Cannon7206/NASA-Motherboard-V4/NASA Motherboard V4.kicad_pcb

## KiCad design NASA Motherboard V4.kicad_pcb (2026-02-16)

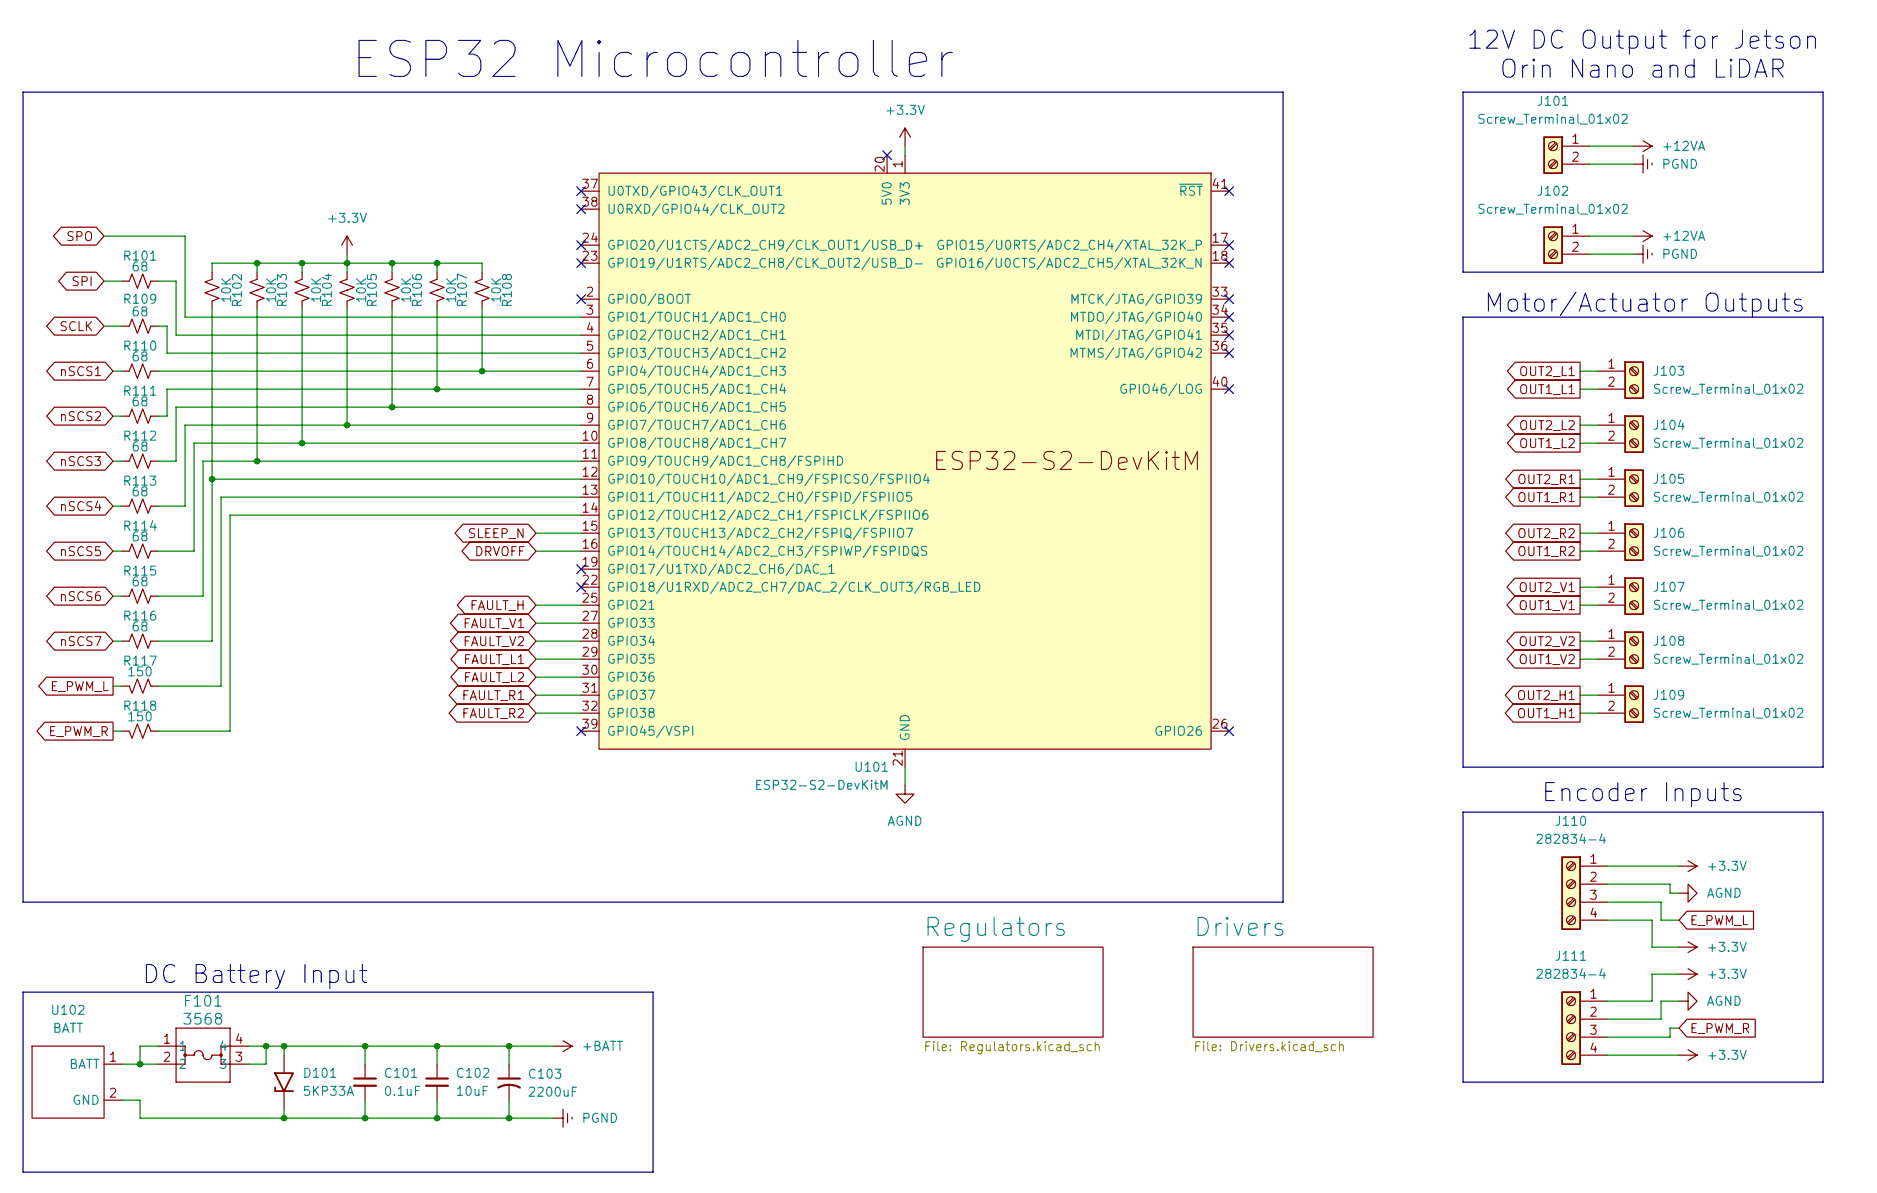
[picture p1: schematic NASA Motherboard V4.kicad_sch, NASA Lunabotics]

Parts:
C101: 0.1uF; C_0402_1005Metric_Pad0.74x0.62mm_HandSolder
C102: 10uF; C_1206_3216Metric_Pad1.33x1.80mm_HandSolder
C103: 2200uF; CP_Radial_D16.0mm_P7.50mm
D101: 5KP33A; D_P600_R-6_P20.00mm_Horizontal
F101: 3568; 3568_KEY
J101, J102: Screw_Terminal_01x02; TerminalBlock_TE_282834-2_1x02_P2.54mm_Horizontal; MFR Part # 282834-2
J103, J104, J105, J106, J107, J108, J109: Screw_Terminal_01x02; TerminalBlock_TE_282834-2_1x02_P2.54mm_Horizontal
J110, J111: 282834-4; TerminalBlock_TE_282834-4_1x04_P2.54mm_Horizontal; MFR Part # 282834-4
R101, R109, R110, R111, R112, R113, R114, R115, R116: 68; R_0402_1005Metric_Pad0.72x0.64mm_HandSolder
R102, R103, R104, R105, R106, R107, R108: 10K; R_0603_1608Metric_Pad0.98x0.95mm_HandSolder
R117, R118: 150; R_0603_1608Metric_Pad0.98x0.95mm_HandSolder
U101: ESP32-S2-DevKitM
U102: BATT; Battery Input

Connections:
+3.3V: J110.1, J110.4, J111.1, J111.4, R102.2, R103.2, R104.2, R105.2, R106.2, R107.2, R108.2, U101.1 (3V3); also elsewhere on the board
+12VA: J101.1, J102.1; also elsewhere on the board
+BATT: C101.1, C102.1, C103.1, D101.2 (A2), F101.3, F101.4; also elsewhere on the board
AGND: J110.2, J111.2, U101.21 (GND), U101.42 (GND); also elsewhere on the board
DRVOFF: U101.16 (GPIO14/TOUCH14/ADC2_CH3/FSPIWP/FSPIDQS); also elsewhere on the board
E_PWM_L: J110.3, R117.2
E_PWM_R: J111.3, R118.2
FAULT_H: U101.25 (GPIO21); also elsewhere on the board
FAULT_L1: U101.29 (GPIO35); also elsewhere on the board
FAULT_L2: U101.30 (GPIO36); also elsewhere on the board
FAULT_R1: U101.31 (GPIO37); also elsewhere on the board
FAULT_R2: U101.32 (GPIO38); also elsewhere on the board
FAULT_V1: U101.27 (GPIO33); also elsewhere on the board
FAULT_V2: U101.28 (GPIO34); also elsewhere on the board
unnamed: R101.2, U101.4 (GPIO2/TOUCH2/ADC1_CH1)
unnamed: R109.2, U101.5 (GPIO3/TOUCH3/ADC1_CH2)
unnamed: R108.1, R110.2, U101.6 (GPIO4/TOUCH4/ADC1_CH3)
unnamed: R107.1, R111.2, U101.7 (GPIO5/TOUCH5/ADC1_CH4)
unnamed: R106.1, R112.2, U101.8 (GPIO6/TOUCH6/ADC1_CH5)
unnamed: R105.1, R113.2, U101.9 (GPIO7/TOUCH7/ADC1_CH6)
unnamed: R104.1, R114.2, U101.10 (GPIO8/TOUCH8/ADC1_CH7)
unnamed: R103.1, R115.2, U101.11 (GPIO9/TOUCH9/ADC1_CH8/FSPIHD)
unnamed: R102.1, R116.2, U101.12 (GPIO10/TOUCH10/ADC1_CH9/FSPICS0/FSPIIO4)
unnamed: R117.1, U101.13 (GPIO11/TOUCH11/ADC2_CH0/FSPID/FSPIIO5)
unnamed: R118.1, U101.14 (GPIO12/TOUCH12/ADC2_CH1/FSPICLK/FSPIIO6)
unnamed: F101.1, F101.2, U102.1 (BATT)
OUT1_H1: J109.2; also elsewhere on the board
OUT1_L1: J103.2; also elsewhere on the board
OUT1_L2: J104.2; also elsewhere on the board
OUT1_R1: J105.2; also elsewhere on the board
OUT1_R2: J106.2; also elsewhere on the board
OUT1_V1: J107.2; also elsewhere on the board
OUT1_V2: J108.2; also elsewhere on the board
OUT2_H1: J109.1; also elsewhere on the board
OUT2_L1: J103.1; also elsewhere on the board
OUT2_L2: J104.1; also elsewhere on the board
OUT2_R1: J105.1; also elsewhere on the board
OUT2_R2: J106.1; also elsewhere on the board
OUT2_V1: J107.1; also elsewhere on the board
OUT2_V2: J108.1; also elsewhere on the board
PGND: C101.2, C102.2, C103.2, D101.1 (A1), J101.2, J102.2, U102.2 (GND); also elsewhere on the board
SCLK: R109.1; also elsewhere on the board
SLEEP_N: U101.15 (GPIO13/TOUCH13/ADC2_CH2/FSPIQ/FSPIIO7); also elsewhere on the board
SPI: R101.1; also elsewhere on the board
SPO: U101.3 (GPIO1/TOUCH1/ADC1_CH0); also elsewhere on the board
nSCS1: R110.1; also elsewhere on the board
nSCS2: R111.1; also elsewhere on the board
nSCS3: R112.1; also elsewhere on the board
nSCS4: R113.1; also elsewhere on the board
nSCS5: R114.1; also elsewhere on the board
nSCS6: R115.1; also elsewhere on the board
nSCS7: R116.1; also elsewhere on the board

Notes on the sheet:
Encoder Inputs
DC Battery Input
12V DC Output for Jetson Orin Nano and LiDAR
Motor/Actuator Outputs
ESP32 Microcontroller

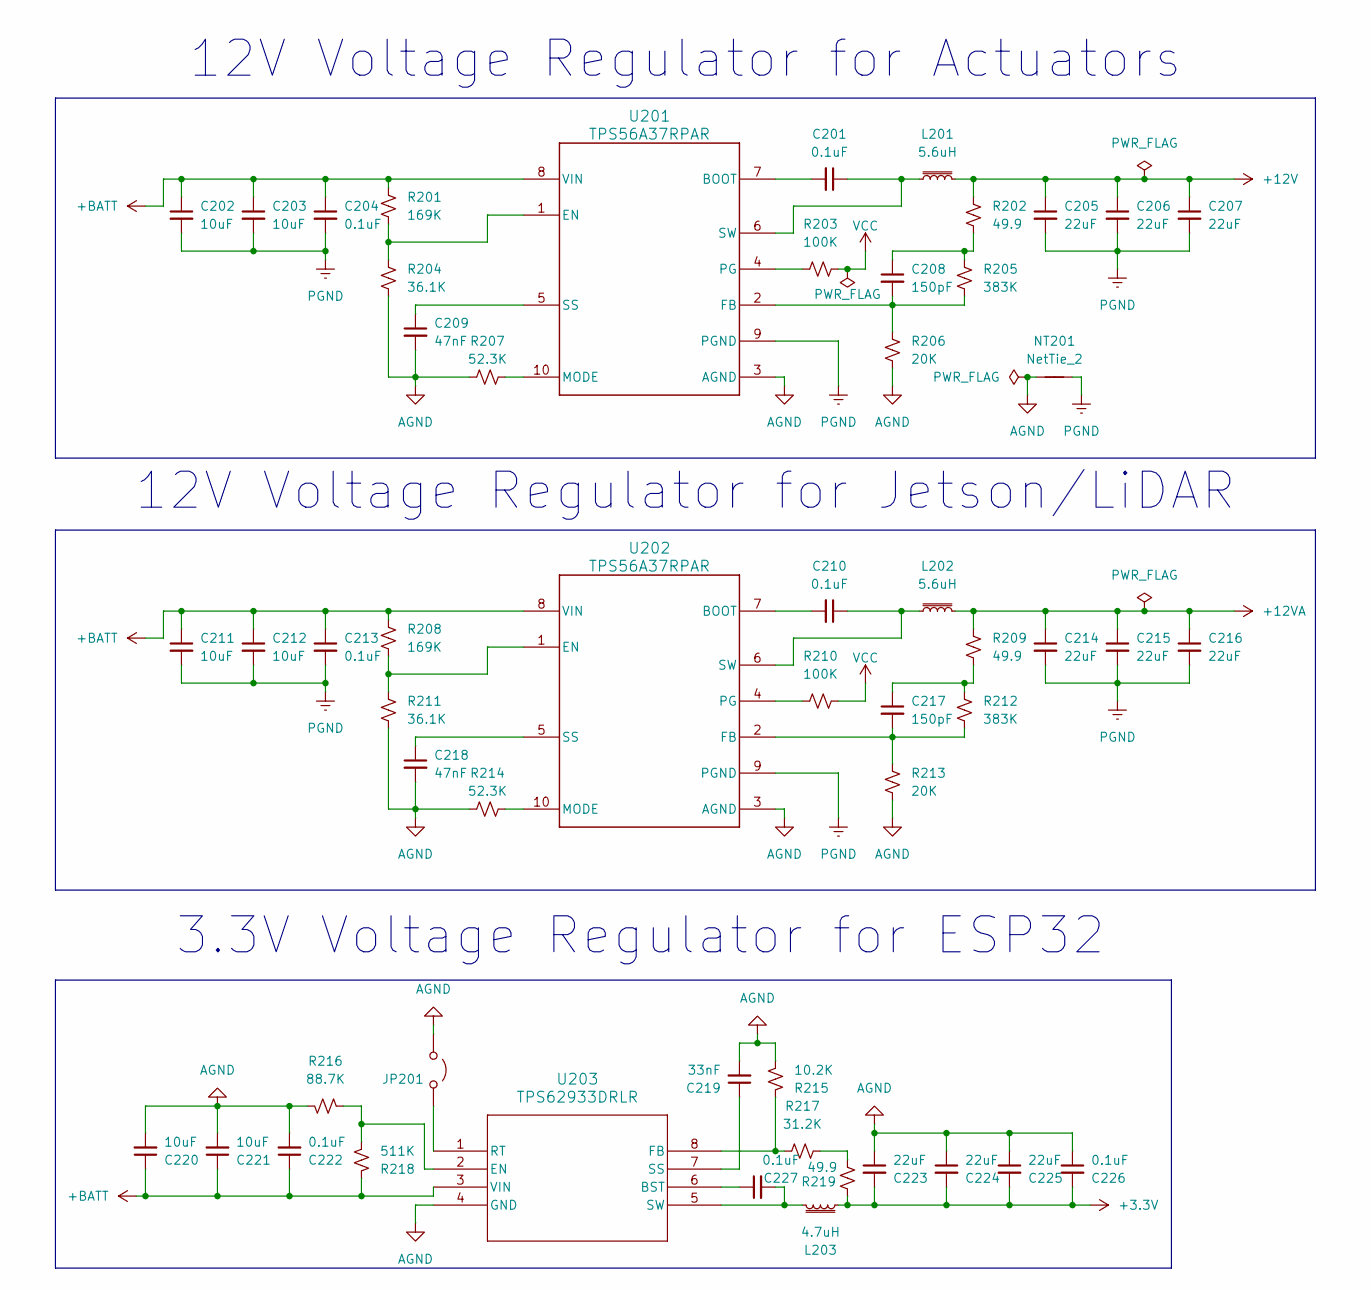
[picture p2: schematic Regulators.kicad_sch, NASA Lunabotics]

Parts:
C201, C204, C210, C213, C222, C226, C227: 0.1uF; C_0402_1005Metric_Pad0.74x0.62mm_HandSolder
C202, C203, C211, C212, C220, C221: 10uF; C_1206_3216Metric_Pad1.33x1.80mm_HandSolder
C205, C206, C207, C214, C215, C216, C223, C224, C225: 22uF; C_1210_3225Metric_Pad1.33x2.70mm_HandSolder
C208, C217: 150pF; C_0402_1005Metric_Pad0.74x0.62mm_HandSolder
C209, C218: 47nF; C_0603_1608Metric_Pad1.08x0.95mm_HandSolder
C219: 33nF; C_0603_1608Metric_Pad1.08x0.95mm_HandSolder
JP201: Jumper_2_Open; SolderJumper-2_P1.3mm_Open_Pad1.0x1.5mm
L201, L202: 5.6uH; IND_IHLP-6767DZ_VIS-M
L203: 4.7uH; IND_SRP6530A_BRN-M
NT201: NetTie_2; NetTie-2_THT_Pad1.0mm
R201, R208: 169K; R_0603_1608Metric_Pad0.98x0.95mm_HandSolder
R202, R209, R219: 49.9; R_0402_1005Metric_Pad0.72x0.64mm_HandSolder
R203, R210: 100K; R_0603_1608Metric_Pad0.98x0.95mm_HandSolder
R204, R211: 36.1K; R_0603_1608Metric_Pad0.98x0.95mm_HandSolder
R205, R212: 383K; R_0603_1608Metric_Pad0.98x0.95mm_HandSolder
R206, R213: 20K; R_0603_1608Metric_Pad0.98x0.95mm_HandSolder
R207, R214: 52.3K; R_0603_1608Metric_Pad0.98x0.95mm_HandSolder
R215: 10.2K; R_0603_1608Metric_Pad0.98x0.95mm_HandSolder
R216: 88.7K; R_0603_1608Metric_Pad0.98x0.95mm_HandSolder
R217: 31.2K; R_0603_1608Metric_Pad0.98x0.95mm_HandSolder
R218: 511K; R_0603_1608Metric_Pad0.98x0.95mm_HandSolder
U201, U202: TPS56A37RPAR; RPA0010A-MFG
U203: TPS62933DRLR; SOT-5X3-8_DRL_TEX

Connections:
+3.3V: C223.2, C224.2, C225.2, C226.2, L203.2, R219.1; also elsewhere on the board
+12V: C205.1, C206.1, C207.1, L201.2, R202.1; also elsewhere on the board
+12VA: C214.1, C215.1, C216.1, L202.2, R209.1; also elsewhere on the board
+BATT: C202.1, C203.1, C204.1, C211.1, C212.1, C213.1, C220.1, C221.1, C222.1, R201.1, R208.1, R218.1, U201.8 (VIN), U202.8 (VIN), U203.3 (VIN); also elsewhere on the board
AGND: C209.2, C218.2, C219.2, C220.2, C221.2, C222.2, C223.1, C224.1, C225.1, C226.1, JP201.1 (A), NT201.1, R204.2, R206.2, R207.2, R211.2, R213.2, R214.2, R215.2, R216.2, U201.3 (AGND), U202.3 (AGND), U203.4 (GND); also elsewhere on the board
unnamed: C208.1, R202.2, R205.1
unnamed: C217.1, R209.2, R212.1
unnamed: JP201.2 (B), U203.1 (RT)
unnamed: R217.2, R219.2
unnamed: C201.2, U201.7 (BOOT)
unnamed: R201.2, R204.1, U201.1 (EN)
unnamed: C208.2, R205.2, R206.1, U201.2 (FB)
unnamed: R207.1, U201.10 (MODE)
unnamed: R203.1, U201.4 (PG)
unnamed: C209.1, U201.5 (SS)
unnamed: C201.1, L201.1, U201.6 (SW)
unnamed: C210.2, U202.7 (BOOT)
unnamed: R208.2, R211.1, U202.1 (EN)
unnamed: C217.2, R212.2, R213.1, U202.2 (FB)
unnamed: R214.1, U202.10 (MODE)
unnamed: R210.1, U202.4 (PG)
unnamed: C218.1, U202.5 (SS)
unnamed: C210.1, L202.1, U202.6 (SW)
unnamed: C227.1, U203.6 (BST)
unnamed: R216.1, R218.2, U203.2 (EN)
unnamed: R215.1, R217.1, U203.8 (FB)
unnamed: C219.1, U203.7 (SS)
unnamed: C227.2, L203.1, U203.5 (SW)
PGND: C202.2, C203.2, C204.2, C205.2, C206.2, C207.2, C211.2, C212.2, C213.2, C214.2, C215.2, C216.2, NT201.2, U201.9 (PGND), U202.9 (PGND); also elsewhere on the board
VCC: R203.2, R210.2

Notes on the sheet:
12V Voltage Regulator for Actuators
3.3V Voltage Regulator for ESP32
12V Voltage Regulator for Jetson/LiDAR

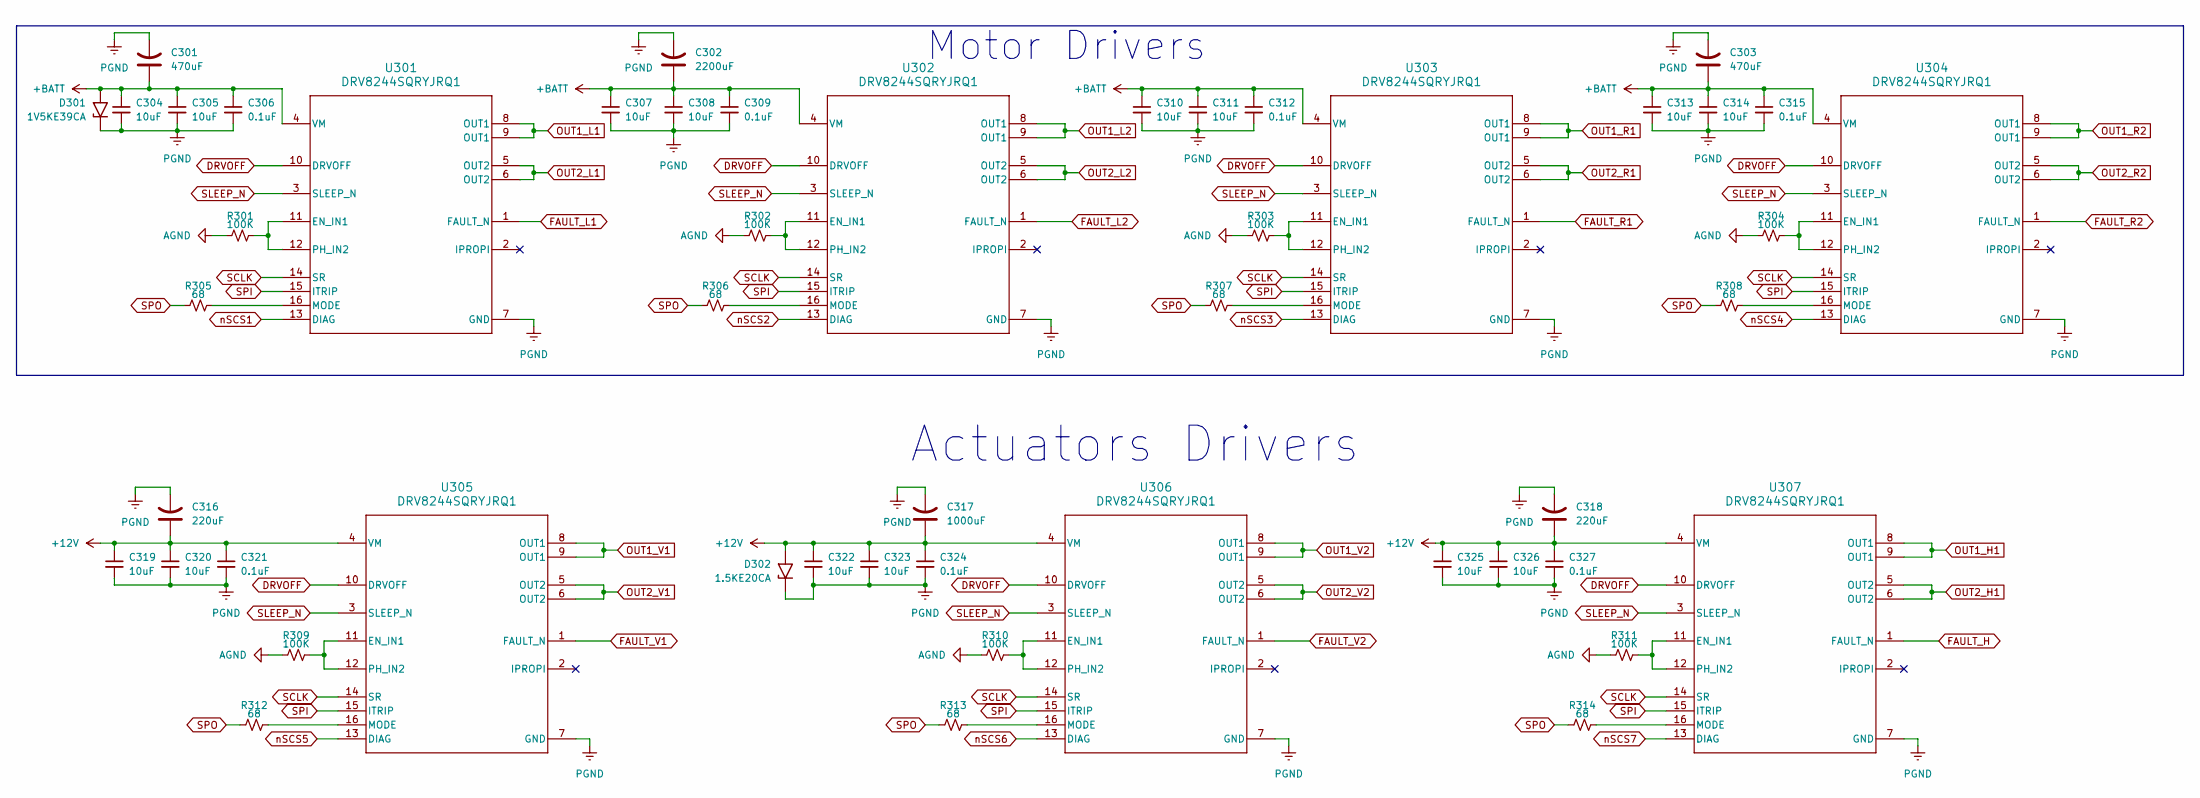
[picture p3: schematic Drivers.kicad_sch, NASA Lunabotics]

Parts:
C301, C303: 470uF; CP_Radial_D12.5mm_P5.00mm
C302: 2200uF; CP_Radial_D16.0mm_P7.50mm
C304, C305, C307, C308, C310, C311, C313, C314, C319, C320, C322, C323, C325, C326: 10uF; C_1206_3216Metric_Pad1.33x1.80mm_HandSolder
C306, C309, C312, C315, C321, C324, C327: 0.1uF; C_0402_1005Metric_Pad0.74x0.62mm_HandSolder
C316, C318: 220uF; CP_Radial_D8.0mm_P3.50mm
C317: 1000uF; CP_Radial_D10.0mm_P5.00mm
D301: 1V5KE39CA; D_DO-201AE_P15.24mm_Horizontal
D302: 1.5KE20CA; D_DO-201AE_P15.24mm_Horizontal
R301, R302, R303, R304, R309, R310, R311: 100K; R_0402_1005Metric_Pad0.72x0.64mm_HandSolder
R305, R306, R307, R308, R312, R313, R314: 68; R_0402_1005Metric_Pad0.72x0.64mm_HandSolder
U301, U302, U303, U304, U305, U306, U307: DRV8244SQRYJRQ1; RYJ0016A-MFG

Connections:
+12V: C316.1, C317.1, C318.1, C319.1, C320.1, C321.1, C322.1, C323.1, C324.1, C325.1, C326.1, C327.1, D302.2 (A2), U305.4 (VM), U306.4 (VM), U307.4 (VM); also elsewhere on the board
+BATT: C301.1, C302.1, C303.1, C304.1, C305.1, C306.1, C307.1, C308.1, C309.1, C310.1, C311.1, C312.1, C313.1, C314.1, C315.1, D301.2 (A2), U301.4 (VM), U302.4 (VM), U303.4 (VM), U304.4 (VM); also elsewhere on the board
AGND: R301.1, R302.1, R303.1, R304.1, R309.1, R310.1, R311.1; also elsewhere on the board
DRVOFF: U301.10 (DRVOFF), U302.10 (DRVOFF), U303.10 (DRVOFF), U304.10 (DRVOFF), U305.10 (DRVOFF), U306.10 (DRVOFF), U307.10 (DRVOFF); also elsewhere on the board
FAULT_H: U307.1 (FAULT_N); also elsewhere on the board
FAULT_L1: U301.1 (FAULT_N); also elsewhere on the board
FAULT_L2: U302.1 (FAULT_N); also elsewhere on the board
FAULT_R1: U303.1 (FAULT_N); also elsewhere on the board
FAULT_R2: U304.1 (FAULT_N); also elsewhere on the board
FAULT_V1: U305.1 (FAULT_N); also elsewhere on the board
FAULT_V2: U306.1 (FAULT_N); also elsewhere on the board
unnamed: R301.2, U301.11 (EN_IN1), U301.12 (PH_IN2)
unnamed: R305.2, U301.16 (MODE)
unnamed: R302.2, U302.11 (EN_IN1), U302.12 (PH_IN2)
unnamed: R306.2, U302.16 (MODE)
unnamed: R303.2, U303.11 (EN_IN1), U303.12 (PH_IN2)
unnamed: R307.2, U303.16 (MODE)
unnamed: R304.2, U304.11 (EN_IN1), U304.12 (PH_IN2)
unnamed: R308.2, U304.16 (MODE)
unnamed: R309.2, U305.11 (EN_IN1), U305.12 (PH_IN2)
unnamed: R312.2, U305.16 (MODE)
unnamed: R310.2, U306.11 (EN_IN1), U306.12 (PH_IN2)
unnamed: R313.2, U306.16 (MODE)
unnamed: R311.2, U307.11 (EN_IN1), U307.12 (PH_IN2)
unnamed: R314.2, U307.16 (MODE)
OUT1_H1: U307.8 (OUT1), U307.9 (OUT1); also elsewhere on the board
OUT1_L1: U301.8 (OUT1), U301.9 (OUT1); also elsewhere on the board
OUT1_L2: U302.8 (OUT1), U302.9 (OUT1); also elsewhere on the board
OUT1_R1: U303.8 (OUT1), U303.9 (OUT1); also elsewhere on the board
OUT1_R2: U304.8 (OUT1), U304.9 (OUT1); also elsewhere on the board
OUT1_V1: U305.8 (OUT1), U305.9 (OUT1); also elsewhere on the board
OUT1_V2: U306.8 (OUT1), U306.9 (OUT1); also elsewhere on the board
OUT2_H1: U307.5 (OUT2), U307.6 (OUT2); also elsewhere on the board
OUT2_L1: U301.5 (OUT2), U301.6 (OUT2); also elsewhere on the board
OUT2_L2: U302.5 (OUT2), U302.6 (OUT2); also elsewhere on the board
OUT2_R1: U303.5 (OUT2), U303.6 (OUT2); also elsewhere on the board
OUT2_R2: U304.5 (OUT2), U304.6 (OUT2); also elsewhere on the board
OUT2_V1: U305.5 (OUT2), U305.6 (OUT2); also elsewhere on the board
OUT2_V2: U306.5 (OUT2), U306.6 (OUT2); also elsewhere on the board
PGND: C301.2, C302.2, C303.2, C304.2, C305.2, C306.2, C307.2, C308.2, C309.2, C310.2, C311.2, C312.2, C313.2, C314.2, C315.2, C316.2, C317.2, C318.2, C319.2, C320.2, C321.2, C322.2, C323.2, C324.2, C325.2, C326.2, C327.2, D301.1 (A1), D302.1 (A1), U301.7 (GND), U302.7 (GND), U303.7 (GND), U304.7 (GND), U305.7 (GND), U306.7 (GND), U307.7 (GND); also elsewhere on the board
SCLK: U301.14 (SR), U302.14 (SR), U303.14 (SR), U304.14 (SR), U305.14 (SR), U306.14 (SR), U307.14 (SR); also elsewhere on the board
SLEEP_N: U301.3 (SLEEP_N), U302.3 (SLEEP_N), U303.3 (SLEEP_N), U304.3 (SLEEP_N), U305.3 (SLEEP_N), U306.3 (SLEEP_N), U307.3 (SLEEP_N); also elsewhere on the board
SPI: U301.15 (ITRIP), U302.15 (ITRIP), U303.15 (ITRIP), U304.15 (ITRIP), U305.15 (ITRIP), U306.15 (ITRIP), U307.15 (ITRIP); also elsewhere on the board
SPO: R305.1, R306.1, R307.1, R308.1, R312.1, R313.1, R314.1; also elsewhere on the board
nSCS1: U301.13 (DIAG); also elsewhere on the board
nSCS2: U302.13 (DIAG); also elsewhere on the board
nSCS3: U303.13 (DIAG); also elsewhere on the board
nSCS4: U304.13 (DIAG); also elsewhere on the board
nSCS5: U305.13 (DIAG); also elsewhere on the board
nSCS6: U306.13 (DIAG); also elsewhere on the board
nSCS7: U307.13 (DIAG); also elsewhere on the board

Notes on the sheet:
Motor Drivers
Actuators Drivers

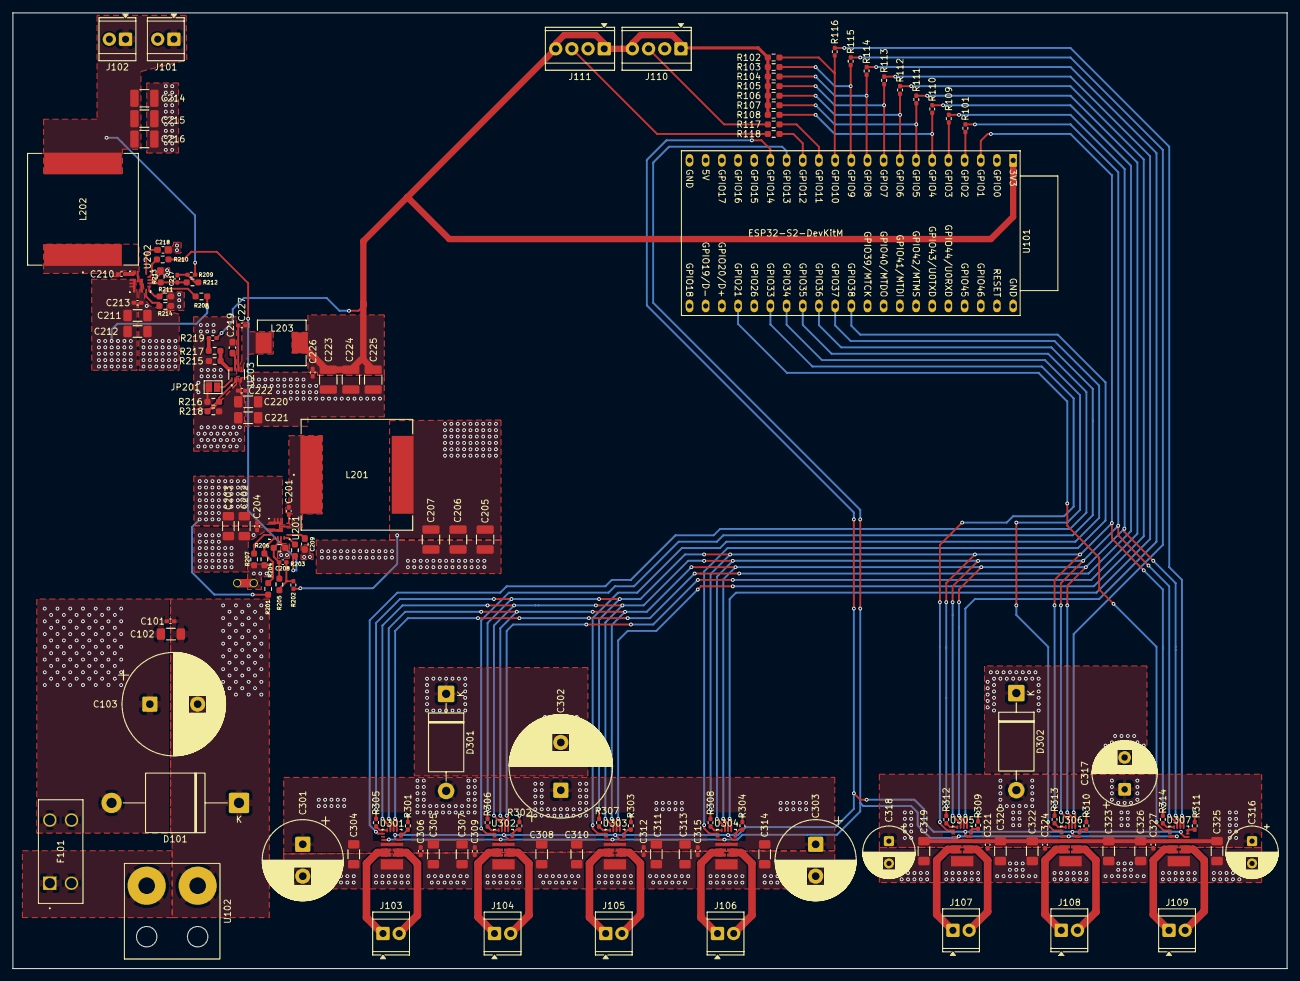
[picture p4: board NASA Motherboard V4.kicad_pcb from above]

Board: 6 copper layers, 200.0 x 150.0 mm, 140 parts (0 on the bottom side), 91 nets.
