Cannon7206/NASA-Motherboard-V4/(commit log)

2026-01-29 Updated settings
    [NASA Motherboard V4.kicad_pcb]
2026-01-30 Minor changes
    [NASA Motherboard V4.kicad_pcb]
2026-01-30 Reorganizing the filetree structure
    [Drivers.kicad_sch, NASA Motherboard V4.kicad_pcb, NASA Motherboard V4.kicad_sch, Regulators.kicad_sch]
